nilbest/Arduino_Project/README.md

# Arduino_Project
 This repository containes all my work around the project i have to do for my University.

 For importing all submdoules please "git submodule init" and "git submodule update".
