nilbest/Arduino_Project/otherinfos/Kalibration/Vergleichswerte.xlsx

 |  |  |  | (Raw/2^24)*(VCC/Gain)
rawValue | Bit | VCC | Gain | Gelesenes Volt
8388736 | 16777216 | 4.91 | 128 | 0.01917998016
8388736
Theoretische Werte des ADC's |  |  |  | Gemessen mit Multimeter in mV
5817012.733 | 16777216 | 4.91 | 128 | 13.3 | 1PSI | 0.0133
25367423.95 | 16777216 | 4.91 | 128 | 58 | 5,8PSI
11101100 | 8 | EC | 2 |  | Min
1110011 | 7 | 73 | 1 |  | 800000 | 8388608
11101101 | 8 | ED | 0 |  | Max
 |  |  |  |  | 7FFFFF | 8388607
11101100 | 8 | EC | 2
1111010 | 7 | 7A | 1 |  |  |  | 1.110110001e+23 | #NUM!
1010000 | 7 | 50 | 0
11101100 | 8 | EC
1010000 | 7 | 50
110010 | 6 | 32
