nilbest/Arduino_Project/otherinfos/Kalibration/Ungenauigkeit der Geräte.pdf

Messgerät | Wert | Einheit
Druckmessgerät | 1 | mmHg
Multimeter [mV] | 0,01 | mV
Multimeter [V] | 0,0021 | V

Ableseungenauigkeit
