nilbest/Arduino_Project/otherinfos/Kalibration/Flusssensor.xlsx

Sheet: Infos
Ableseungenauigkeit
Messgerät | Wert | Einheit
Druckmessgerät | 1 | mmHg
Multimeter [mV] | 0.01 | mV
Multimeter [V] | 0.0021 | V

Sheet: Messwerte Flusssensor
Messreihe 1 |  |  |  |  |  |  | Anfang | Mitte | Ende
Messbehällter [L] | Dauer [Sec] | Errechneter Durchfluss [L/sec] | Impulse Sensor | Gewicht [kg] | Eigengewicht Eimer [kg] | Volumen Messung [L] | Durchfluss Messung [L/sec] | Durchfluss Messung [L/sec] | Durchfluss Messung [L/sec] | Mittelwert
10 | 39.77 | 0.2514458134 | 4554 | 10.6 | 0.368 | 10.12 | 0.26 | 0.27 | 0.27 | 0.2666666667
10 | 56.2 | 0.1779359431 | 4256 | 9.9 | 0.368 | 9.96 | 0.19 | 0.19 | 0.19 | 0.19
10 | 46.47 | 0.2151925974 | 4617 | 10.7 | 0.368 | 10.26 | 0.22 | 0.23 | 0.22 | 0.2233333333
10 | 42.5 | 0.2352941176 | 4411 | 10.3 | 0.368 | 9.8 | 0.24 | 0.25 | 0.25 | 0.2466666667
10 | 46.09 | 0.2169668041 | 4404 | 10.2 | 0.368 | 9.79 | 0.21 | 0.23 | 0.22 | 0.22
10 | 41.47 | 0.2411381722 | 4343 | 10.2 | 0.368 | 9.65 | 0.26 | 0.25 | 0.25 | 0.2533333333
10 | 41.74 | 0.2395783421 | 4520 | 10.5 | 0.368 | 10.04 | 0.23 | 0.26 | 0.26 | 0.25
10 | 34.82 | 0.2871912694 | 4256 | 9.9 | 0.368 | 9.46 | 0.3 | 0.29 | 0.29 | 0.2933333333
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
