nilbest/Arduino_Project/otherinfos/Anhang/Arduino_Projekt_Rohrverengung_Schematic.pdf

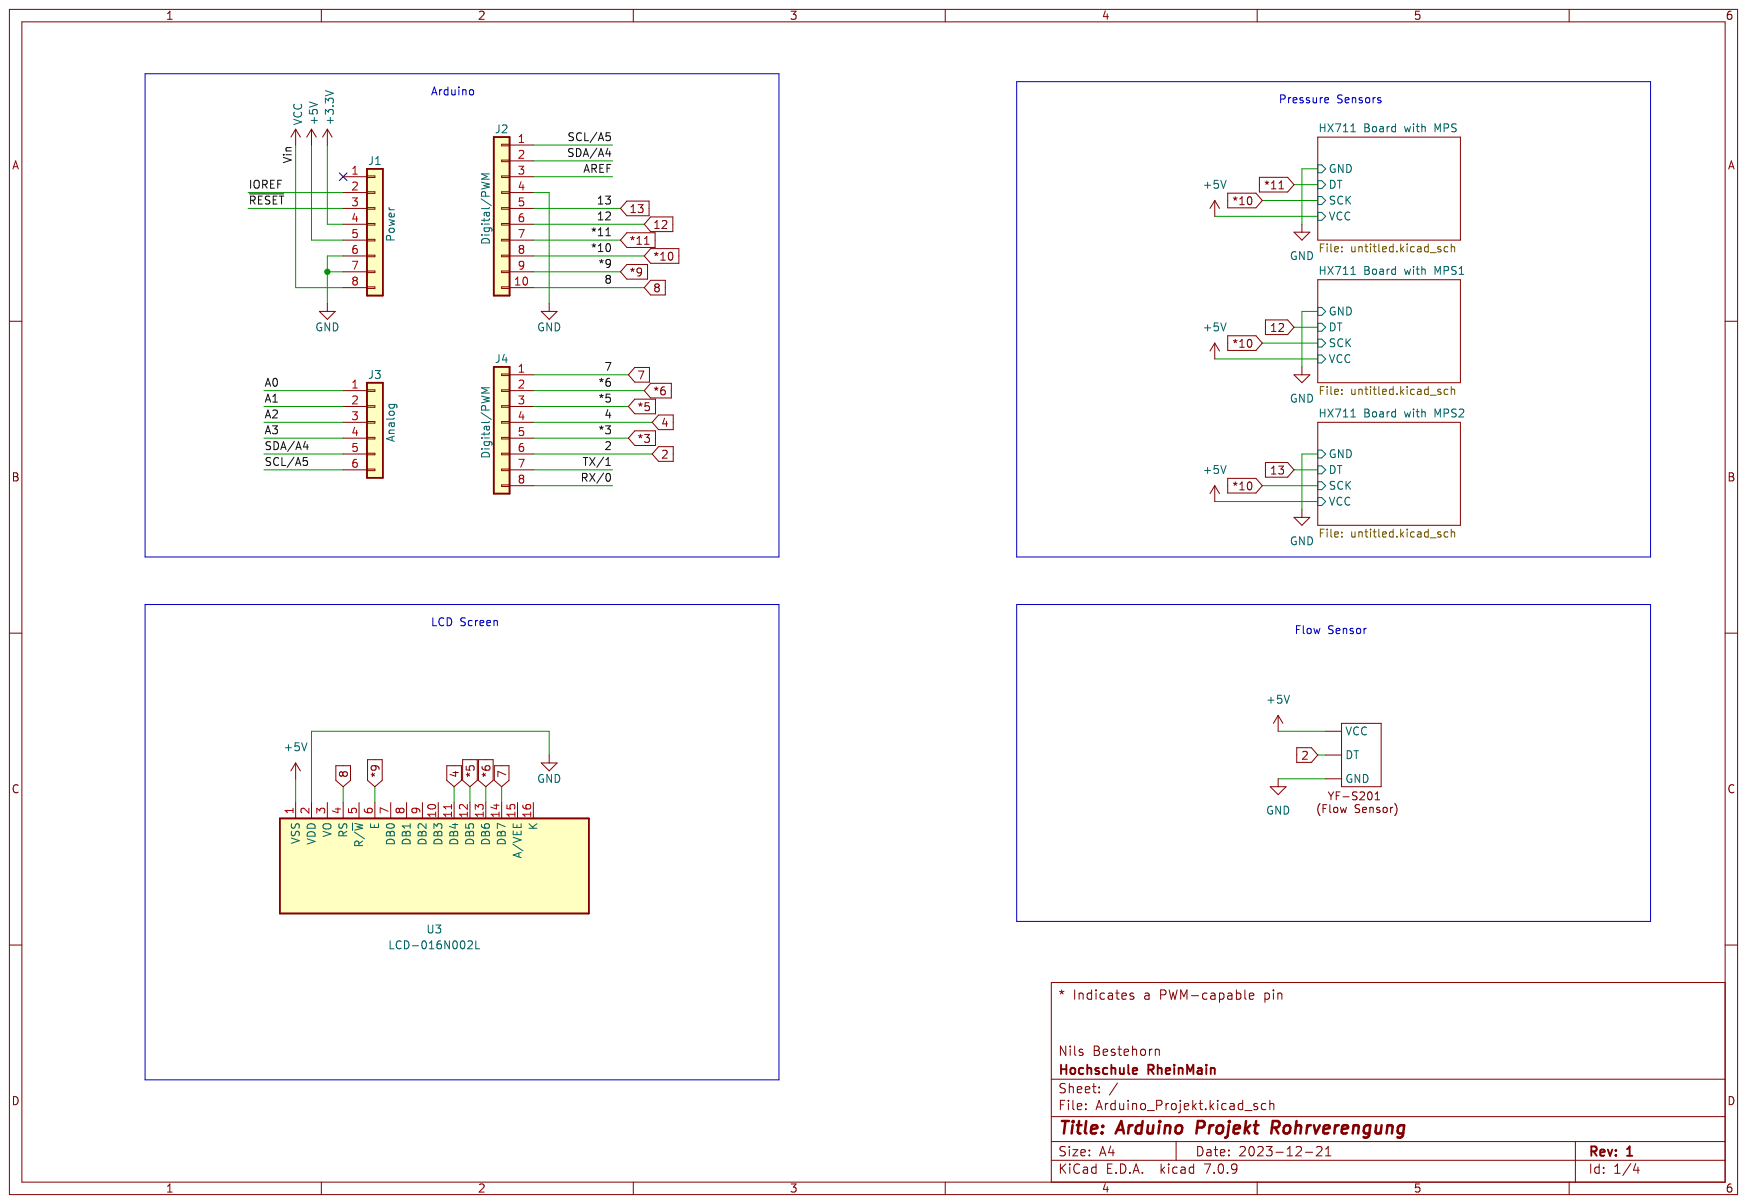
[picture p4: page 1]

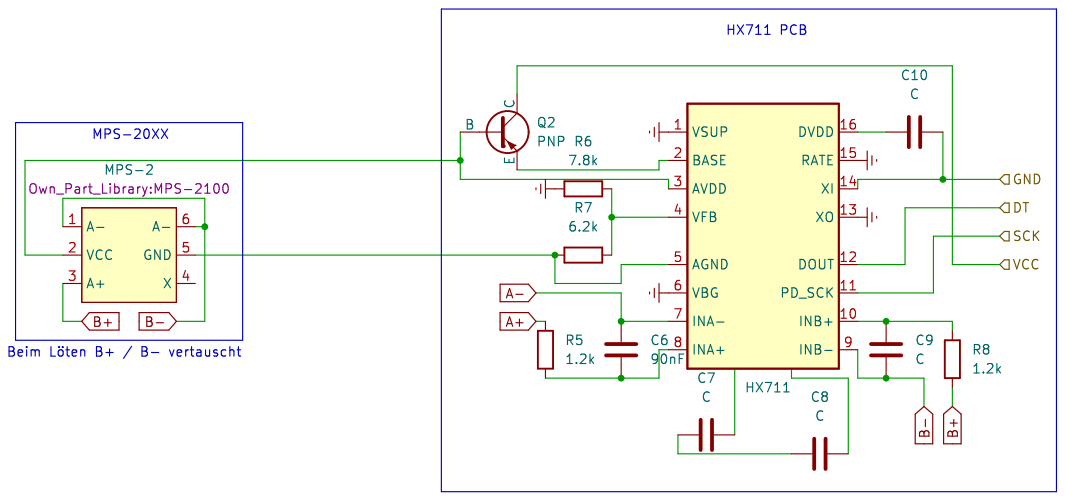
[picture p5: page 2]

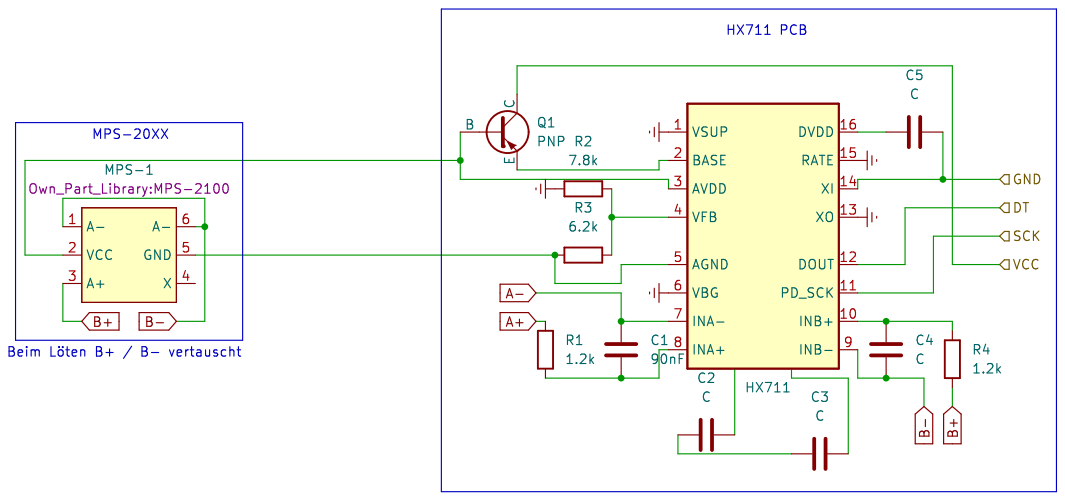
[picture p6: page 3]

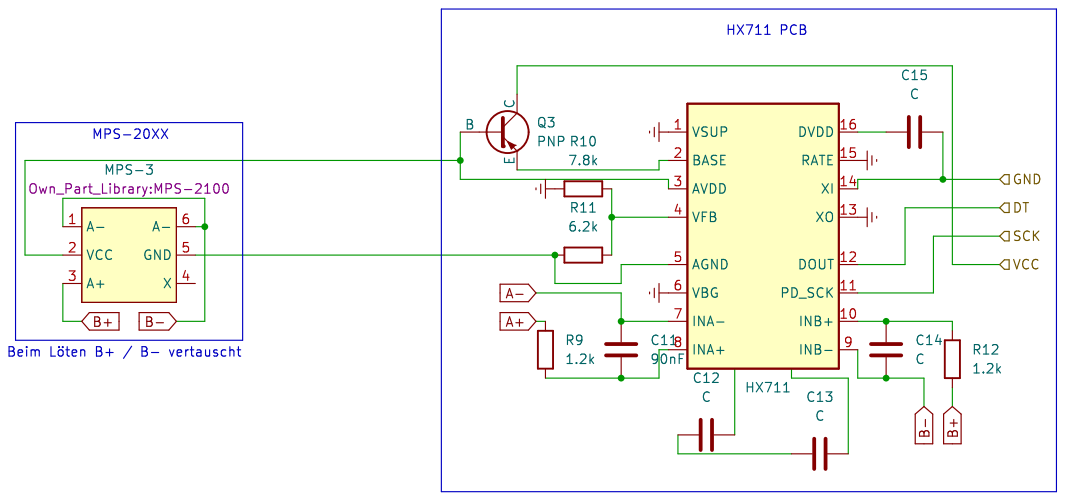
[picture p7: page 4]
