nilbest/Arduino_Project/(commit log)

2023-04-07 Testing seperating Timer
2023-04-13 Added Fork of FlowSensor-Arduino
2023-04-13 Removed FlowSensor-Arduino Lib
2023-05-07 created new PressureSensor files
2023-05-07 Test Sesnor Data, 512-516, via mouth, because of 5V reference
2023-05-08 Added basic Read Pressure Sensor, Problem Output negativ makes no Sense
    [main.cpp]
2023-06-03 How I Tested Flow Rate
2023-06-08 Fixed Sensor Output, with Test
    [main.cpp]
2023-06-25 Tested and got Problem with HX711MULTI, trying to make own Implementation but with classes in the future
    [main.cpp]
2023-06-25 Basic read of the HX711 ADC, is working
2023-08-03 Problem beim einlesen der Werte
    [main.cpp]
2023-08-18 Basic Setup for multi Pressure Sensors
2023-08-18 Corrected main.cpp for Test with 3 Sensors
    [main.cpp]
2023-08-26 Last Update for testing on Laptop 26.08
    [DruckSensor.xlsx]
2023-09-06 Added Multi reading for 3 Sensors
2023-09-20 Changed read Funktion
    [Vergleichswerte.xlsx]
2023-09-27 Tryed positiv Value reading, but the number is negativ with better behaviour, needs fix!!!
    [Vergleichswerte.xlsx]
2023-10-01 Fixed Reading HX711 Sensor Pulses. And Added print_private_Data Function
    [main.cpp]
2023-10-23 Fixed Multi Sensor Readings; Added Overwrite Function so it does not matter where what was written in each SCK PIN before adding to Multi Sensor
    [main.cpp]
2023-10-23 Added Test Function for reducing RAM via outsurcing print Statements
2023-10-31 Basic Kalibration for voltage
    [DruckSensor (version 1).xlsx, DruckSensor.xlsx, Vergleichswerte.xlsx]
2023-11-03 Basic Kalibration Test's
    [DruckSensor (version 1).xlsx]
2023-11-06 Added Funktion set_P_m_and_P_b also renamed set_slope_and_y... to set_U_m_and_U_b
    [DruckSensor (version 1).xlsx]
2023-11-06 P1 Calibrated
    [DruckSensor (version 1).xlsx]
2023-11-07 Calibrated P2
    [DruckSensor (version 1).xlsx]
2023-11-07 Calibrated P3
    [DruckSensor (version 1).xlsx]
2023-11-10 Trying to outsurce print Functions
2023-11-10 Fixed Layout and ghost Functions, also found seperators # used a lot of memory
    [main.cpp]
2023-11-10 Updated Lib FlowSensor-Arduino
2023-11-10 Deleted Timer and WaterFlowSensor, not used
2023-11-10 Added PDF's and modified xlsx file
    [DruckSensor (version 1).xlsx]
2023-11-19 added Functio for handling Float numbers, but still buggy
    [main.cpp]
2023-11-19 Pressure and Flow in one code
2023-11-19 Fixed Format_number_spaces Function, by using dtostrf.
    [main.cpp]
2023-11-26 Data Flusssensor
    [DruckSensor (version 1).xlsx, DruckSensor.xlsx, Flusssensor.xlsx]
2023-11-29 Added Info / Data Flowsensor
    [DruckSensor (version 1).xlsx, Flusssensor.xlsx]
2023-12-03 fixed Datatables
    [DruckSensor (version 1).xlsx, Sensor_Kalibrierung.xlsx]
2024-03-01 Cleaned PressureSensor Code
